jessons/DC_ups/成品全.jpg

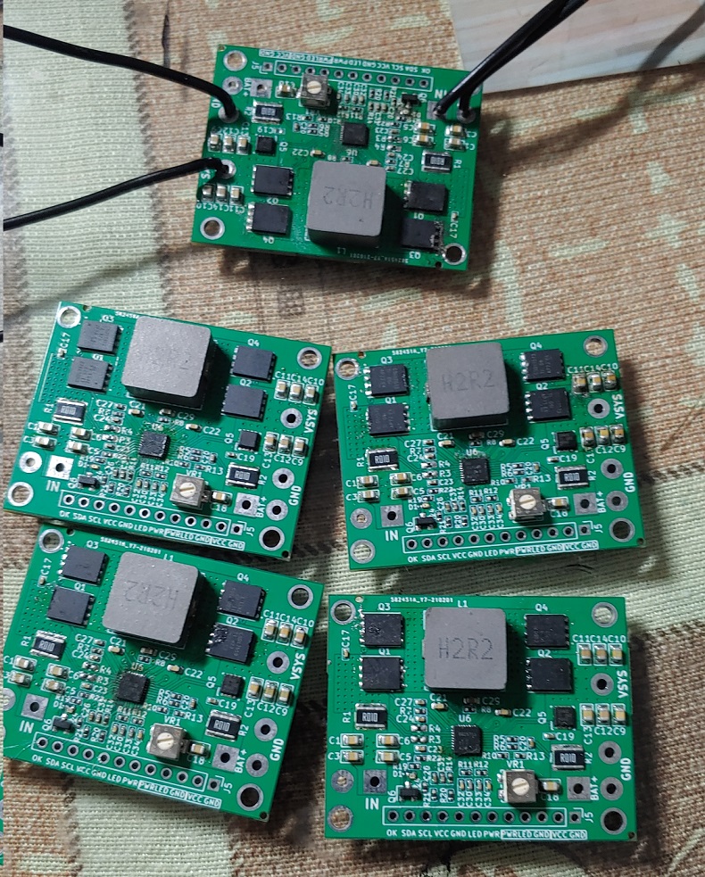
成品全.jpg
