jessons/DC_ups/单个成品.jpg

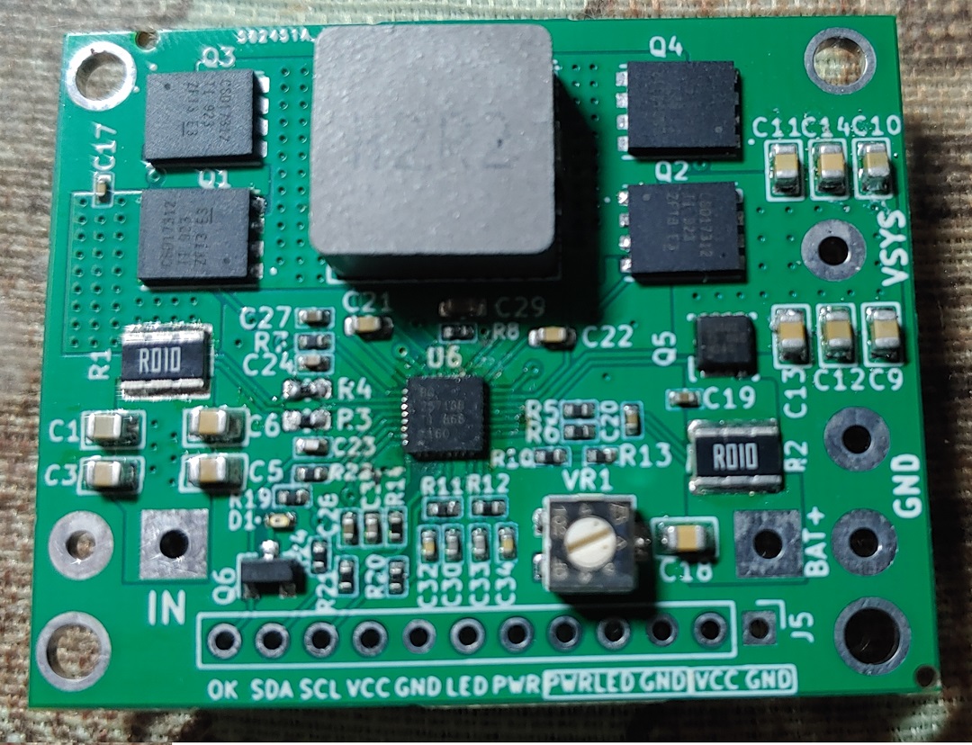
单个成品.jpg
