jessons/DC_ups/电气原理图.pdf

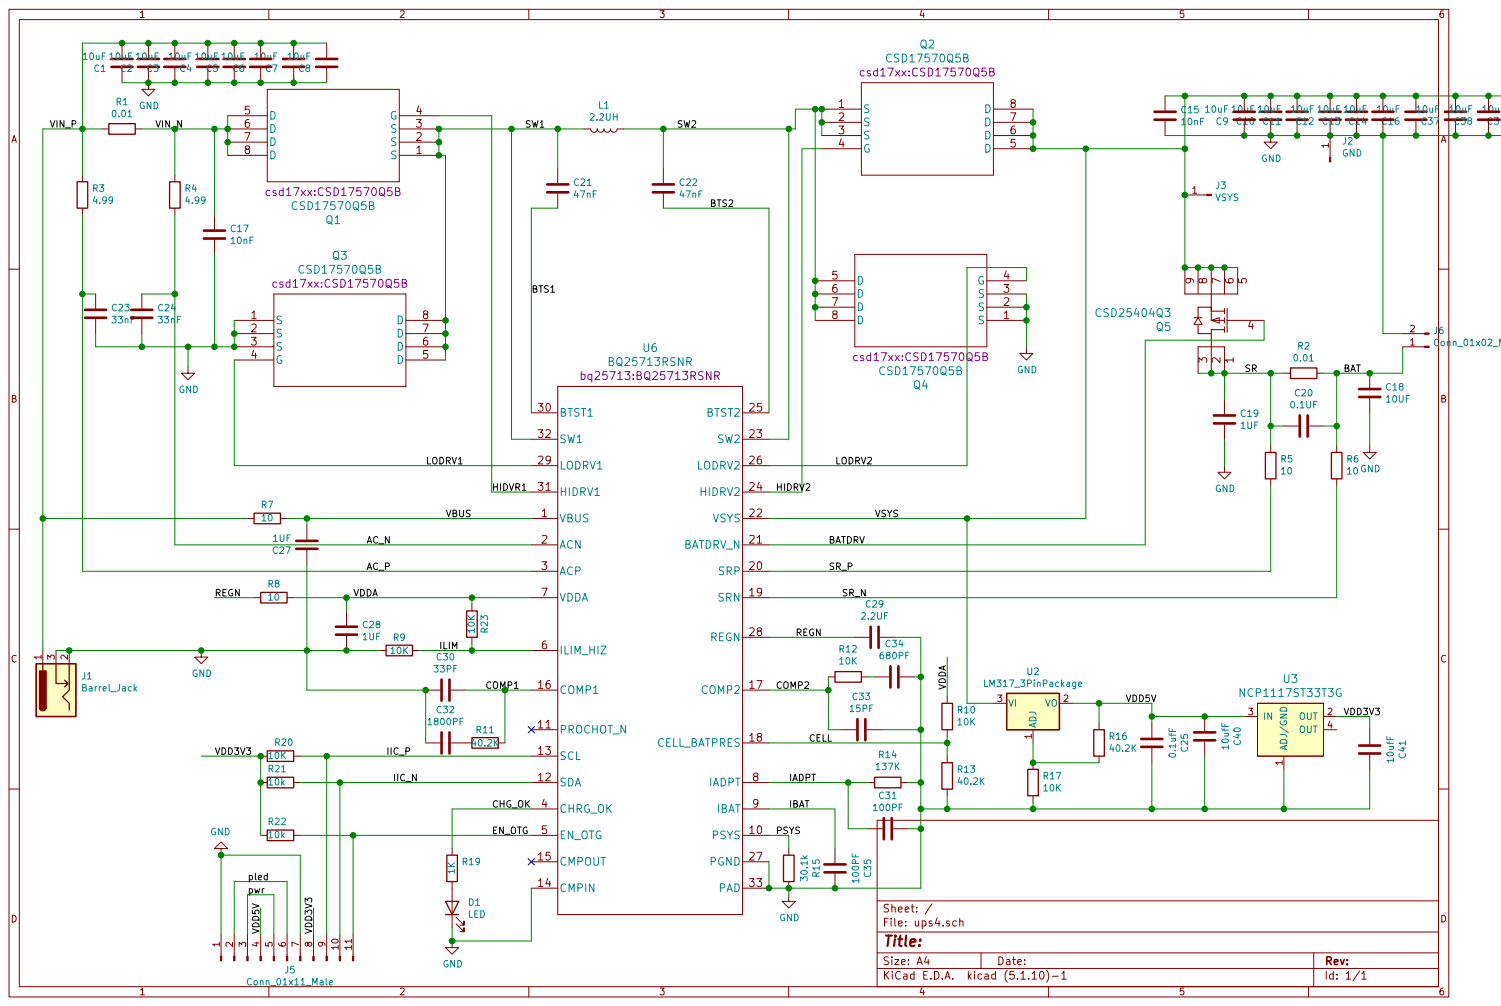
[picture p3: page 1]

VDDA AC_P REGN | SR_P REGN SR_N

ILIM_HIZ 6 VDDA 7
