jessons/DC_ups/(commit log)

2022-02-07 第一版V0.1
    第一版 测试版
2022-02-07 bq25713使用手册
2022-02-07 bq25713驱动板
2022-02-07 驱动板成品图片
2022-02-11 Update bq25713test.ino
    修改几个错误，调整一下代码布局
2022-02-14 Update bq25713test.ino
    优化代码框架
2022-02-14 更新逻辑错误
    更新多处逻辑错误，
2022-02-15 Update bq25713test.ino
    修改多处逻辑错误
2022-02-16 说明文档
2022-02-16 工作区配置文件
2022-02-16 成品板子
2022-02-16 调整代码及注释
2022-02-16 完善注释
2022-02-16 复用一个gpio实现配置和开关机功能
2022-02-16 修改一个bug
2022-02-16 主程序 v0.1
2022-02-17 完善说明
2022-02-18 设定语言
2022-02-19 1 增加一个开机判断条件，输入电压大于设定输入电压。2 手动关机后ups不再自动控制开机
2022-02-19 增加mac做mqtt id
2022-02-19 增加自动开关机功能设置，修改电量百分比估算方法
2022-02-27 添加自定义订阅主题前缀功能，修改完成部分
2022-02-28 增加设置主题前缀功能，修改完成
2022-02-28 前缀功能测试通过
2022-03-01 修改2处错误，1无法设定充电电压，充电电流监控主题多了一个“/”
2022-03-14 添加一处注释说明
2022-03-16 修复充电电压设置低8位丢失问题
2022-03-17 修复几处错误
2022-03-19 优化硬件接线，减少代码处理
2022-03-23 修改几处bug，可以正常使用版
2022-03-23 修改说明文件，主题前缀说明
